cvdenzen/TrinketLedDimmer/schema/noname.sch

## KiCad design schema/noname.sch (2014-06-02)

Schematic: noname.sch

Parts:
R1, R2: 68
R3: 1k5
R11, R12: 1k
R13, R14: 100k
R15, R16: 22k
SW1, SW2: SW_PUSH

Notes on the sheet:
Dimmer pin layout change: Date 20140517 Function Pin Comments Button1 PB2 Button2 PB4 With 1k resistor in series to avoid short circuit at boot time Light1 PB0=OC1A(inv) Inverted, software must handle this Light2 PB3=OC1B(inv) Inverted, software must handle this
light2
light1
Light1
SOT-23
+5V
