cvdenzen/TrinketLedDimmer/(commit log)

2014-05-15 Arduino IDE needs the files in a directory. Moved files into directory sketch_leddimmerwithpushbutton
2014-05-15 Timing timing and added schematic file (not yet ready!)
    [noname.sch]
2014-05-17 Use other pins
    The Trinket boot makes the led flicker at startup (even without usb
    connection). Use other pins that are not used by the boot software.
    [noname.sch]
2014-05-17 added fet footprint in schema
    [noname.sch]
2014-05-22 Schema updated, software updated
    This works (tested) for light 1.
    [noname.sch]
2014-05-24 Working for 1 light
    Light #1 works with button at PB2 and light at PB0.
    Button 2 is a problem (Digital enable bit?? for PB4??), the light at PB3
    is working, but not functional as it cannot be controlled by button 2.
    [leddimmerwithpushbutton.h, sketch_leddimmerwithpushbutton.ino]
2014-06-02 Fade out implemented
    But I don't like it, it flickers too much (due to pwm in attiny?)
    [noname.sch]
2014-07-08 Removed debug code and solved startup problem
    light 2 would startup at half power (for a few milliseconds?). Now it
    will startup with power 0, but I needed a delay for this to avoid
    flickering.
    [sketch_leddimmerwithpushbutton.ino]
